Cyril-Meyer/SSG-Synth/music.h

#ifndef MUSIC_H
#define MUSIC_H

// Define notes places in frequency array
#define C  0
#define Cd 1

#define Db 1
#define D  2
#define Dd 3

#define Eb 3
#define E  4

#define F  5
#define Fd 6

#define Gb 6
#define G  7
#define Gd 8

#define Ab 8
#define A  9
#define Ad 10

#define Bb 10
#define B  11

// Define notes frequencies
/*
const float PROGMEM note_frequency[12][11] = {
{16.35, 32.70, 65.41,  130.81, 261.63, 523.25, 1046.50, 2093.00, 4186.01, 8372.02,  16744.04},
{17.33, 34.65, 69.30,  138.59, 277.18, 554.37, 1108.73, 2217.46, 4434.92, 8869.84,  17739.68},
{18.36, 36.71, 73.42,  146.83, 293.66, 587.33, 1174.66, 2349.32, 4698.64, 9397.28,  18794.56},
{19.45, 38.89, 77.78,  155.56, 311.13, 622.25, 1244.51, 2489.02, 4978.03, 9956.06,  19912.12},
{20.60, 41.20, 82.41,  164.81, 329.63, 659.26, 1318.51, 2637.02, 5274.04, 10548.08, 21096.16},
{21.83, 43.65, 87.31,  174.61, 349.23, 698.46, 1396.91, 2793.83, 5587.65, 11175.30, 22350.60},
{23.13, 46.25, 92.50,  185.00, 369.99, 739.99, 1479.98, 2959.96, 5919.91, 11839.82, 23679.64},
{24.50, 49.00, 98.00,  196.00, 392.00, 783.99, 1567.98, 3135.96, 6271.93, 12543.86, 25087.72},
{25.96, 51.91, 103.83, 207.65, 415.30, 830.61, 1661.22, 3322.44, 6644.88, 13289.76, 26579.52},
{27.50, 55.00, 110.00, 220.00, 440.00, 880.00, 1760.00, 3520.00, 7040.00, 14080.00, 28160.00},
{29.14, 58.27, 116.54, 233.08, 466.16, 932.33, 1864.66, 3729.31, 7458.62, 14917.24, 29834.48},
{30.87, 61.74, 123.47, 246.94, 493.88, 987.77, 1975.53, 3951.07, 7902.13, 15804.26, 31608.52}
};
*/
const float PROGMEM midi_frequency[104] = {
32.70, 34.65, 36.71, 38.89, 41.20, 43.65, 46.25, 49.00, 51.91, 55.00, 58.27, 61.74,
65.41, 69.30, 73.42, 77.78, 82.41, 87.31, 92.50, 98.00, 103.83, 110.00, 116.54, 123.47,
130.81, 138.59, 146.83, 155.56, 164.81, 174.61, 185.00, 196.00, 207.65, 220.00, 233.08, 246.94,
261.63, 277.18, 293.66, 311.13, 329.63, 349.23, 369.99, 392.00, 415.30, 440.00, 466.16, 493.88,
523.25, 554.37, 587.33, 622.25, 659.26, 698.46, 739.99, 783.99, 830.61, 880.00, 932.33, 987.77,
1046.50, 1108.73, 1174.66, 1244.51, 1318.51, 1396.91, 1479.98, 1567.98, 1661.22, 1760.00, 1864.66, 1975.53,
2093.00, 2217.46, 2349.32, 2489.02, 2637.02, 2793.83, 2959.96, 3135.96, 3322.44, 3520.00, 3729.31, 3951.07,
4186.01, 4434.92, 4698.64, 4978.03, 5274.04, 5587.65, 5919.91, 6271.93, 6644.88, 7040.00, 7458.62, 7902.13,
8372.02, 8869.84, 9397.28, 9956.06, 10548.08, 11175.30, 11839.82, 12543.86};

#endif
