Cyril-Meyer/SSG-Synth/SSG.h

#ifndef SSG_H
#define SSG_H

#include "Arduino.h"
#include "pins.h"

// Include notes frequencies
#include "music.h"

// Delay in microseconds we allow the chip to react after mode changes or register access
#define us_delay 1

// We use a 4Mhz crystal oscillator and set /SEL to low, the input clock is divided by 2 and equal 2Mhz
#define fMaster 2000000

// channels for SSG::set_chan_frequency
#define chanA 0b001
#define chanB 0b010
#define chanC 0b100

class SSG
{
  public:
    SSG();

    // Music
    /*
    void set_chan_frequency(word note, word octave, char chan = 7);
    */
    void set_chan_frequency(byte note, char chan = 7);
    void set_chan_frequency_null(char chan = 7);
    /*
    void set_chanA_frequency(int note, int octave);
    void set_chanB_frequency(int note, int octave);
    void set_chanC_frequency(int note, int octave);
    */
    void set_chanA_frequency(byte note);
    void set_chanB_frequency(byte note);
    void set_chanC_frequency(byte note);

    // Level control
    // Using the level control, you disable the use of the envelope
    void set_chan_level(char level, char chan = 7);
    void set_chan_level_null(char chan = 7);
    void set_chanA_level(char level);
    void set_chanB_level(char level);
    void set_chanC_level(char level);

    // Noise
    void set_noise_frequency(char NP);

    // Mixer
    void set_chan_mixer(bool music, bool noise, char chan = 7);
    void set_chan_mixer_mute(char chan = 7);
    void set_chanA_mixer(bool music, bool noise);
    void set_chanB_mixer(bool music, bool noise);
    void set_chanC_mixer(bool music, bool noise);
    
    // Envelope
    // To use the the envelope, you need to enable it on channels
    void set_envelope_frequency(word EP);
    void set_envelope_shape(bool cont, bool att, bool alt, bool hold);
    void set_chan_use_envelope(char chan = 7);
    void set_chanA_use_envelope();
    void set_chanB_use_envelope();
    void set_chanC_use_envelope();
    
  private:
    /*
    // convert note and octave into a word
    word note_to_YM(word note, word octave);
    */
    // convert midi note number into a word
    word midi_to_YM(byte note);

    // Modes
    /* We only use 3 possible state of BC1, BC2, BDIR combination.
     *
     *          | BC1 | BC2 | BDIR |
     * Inactive |  1  |  0  |   1  |
     * Write    |  0  |  1  |   1  |
     * Address  |  1  |  1  |   1  |
     *
     * We could remove the digitalWrite(BDIR, HIGH),
     * but we still keep it if we want to use the read functions.
      */
    void set_mode_inactive();
    void set_mode_write();
    void set_mode_address();

    // Write
    void set_address(char address);
    void set_data(char data);
    void write_data(char address, char data);

    // Mixer current status
    char mixer_status;
};

#endif
