Cyril-Meyer/SSG-Synth/pins.h

#ifndef PINS_H
#define PINS_H

// Define pinout
#define DA0 5
#define DA1 6
#define DA2 7
#define DA3 8
#define DA4 9
#define DA5 10
#define DA6 11
#define DA7 12
#define BC1 4
#define BC2 3
#define BDIR 2
#define ENV_CONT A0
#define ENV_ATT  A1
#define ENV_ALT  A2
#define ENV_HOLD A3
#define ENV_FREQ A4
#define INIT_SETUP_DATA A5
#define INIT_SETUP_CLOCK 13
#define INIT_SETUP_LATCH 12

#endif
