Cyril-Meyer/SSG-Synth/(commit log)

2021-03-12 Create Arduino project
2021-03-13 update README, add schematics
2021-03-13 upload YM2149F pin layout
2021-03-13 upload midi input interface schematics
2021-03-13 control SSG chip using Arduino (fixed code from Arduino-YM-Sound-Chips)
    [SSG-Synth.ino, SSG.cpp, SSG.h, music.h, utils.ino]
2021-03-14 clean code, prepare envelope support, and add velocity support. need improvement to void crack noise
    [SSG-Synth.ino]
2021-03-16 velocity support
